mitjakarki/remote_camera/README.md

# remote_camera
Hacking a remote shutter to a digital camera.

University of Oulu course "Principles of repurposing electronics" (521229A) course work.
