mitjakarki/remote_camera/mechanics/case_v02.stl

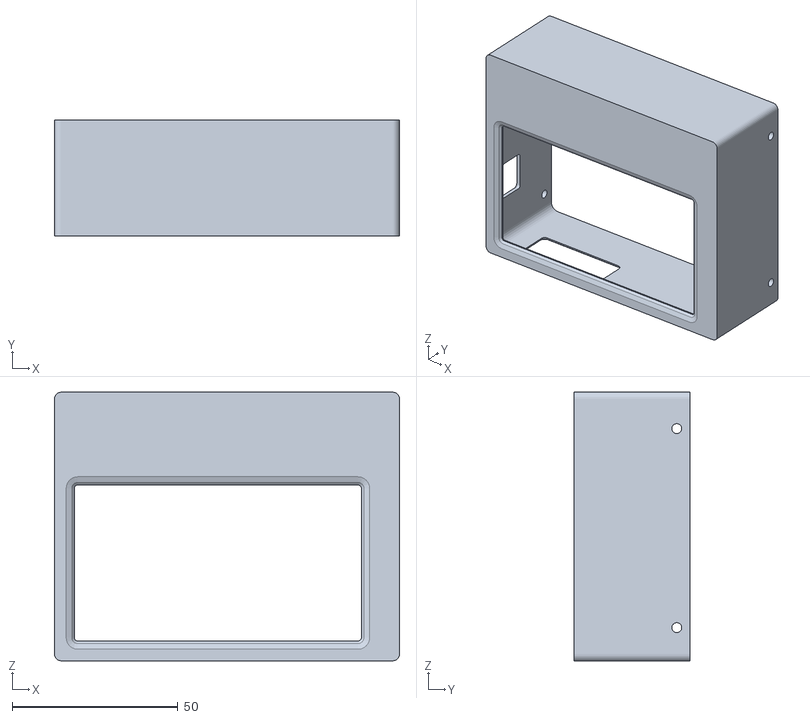
[picture p15: CAD file, 2019-10-20]
mechanics/case_v02.stl
104.0 x 35.0 x 81.0
