mitjakarki/remote_camera/mechanics/case_lid_v03.stl

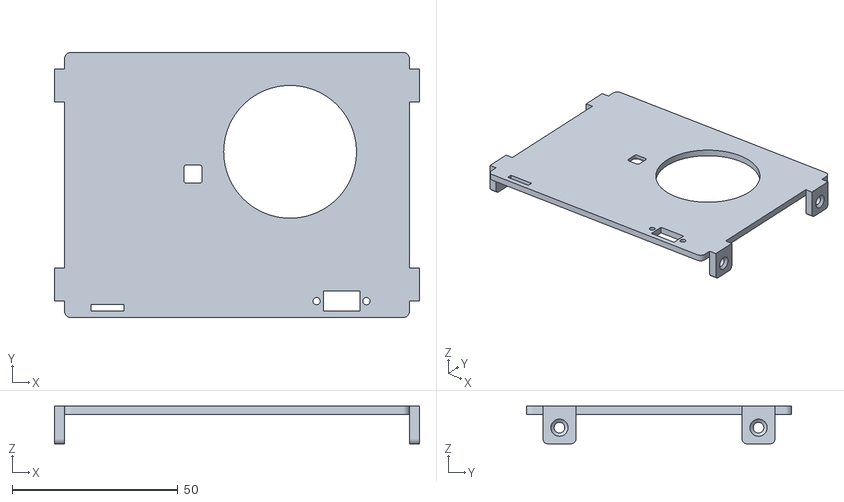
[picture p16: CAD file, 2019-10-20]
mechanics/case_lid_v03.stl
110.0 x 80.0 x 11.4
