mitjakarki/remote_camera/images/shutter_wires_soldered.jpg

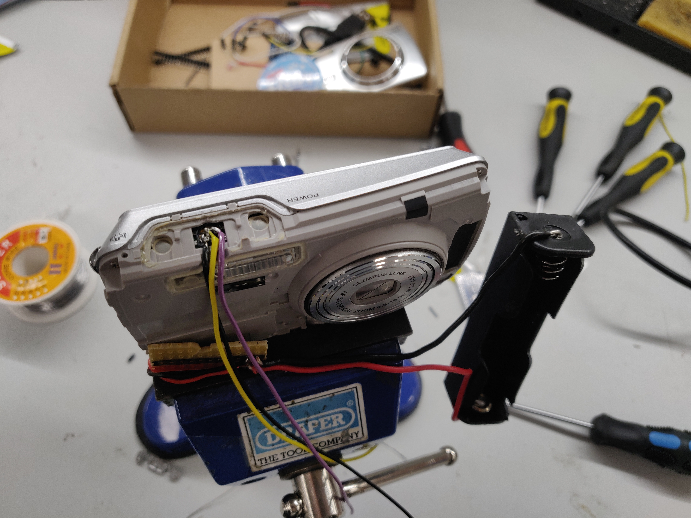
images/shutter_wires_soldered.jpg
